HugoJosh/DSP_Ecualizador/README.md

Equalizer project using the TIVA controller manipulated wirelessly via Bluetooth
