HugoJosh/DSP_Ecualizador/(list of files, drawings)

Other design files:
Diseño1.ms14
